mahmutkucukakyuz-iuc/robotik_vize/rapor/sonuclar/fk_error_20261030_123836.md

| Konf. | q (deg) | p_FK (m) | p_ROS /ee_pose (m) | e_ROS (mm) | p_Gazebo (m) | e_Gazebo (mm) | e_Gazebo, FK(q_olc) (mm) |
|---|---|---|---|---|---|---|---|
| T1 | 0, 0, 0, 0, 0, 0 | 0.0000, -0.0008, 0.7921 | 0.0000, -0.0008, 0.7921 | 0.0000 | 0.0000, -0.0008, 0.7921 | 0.0003 | 0.0003 |
| T2 | 45, 20, 0, 0, 0, 0 | 0.1604, 0.1593, 0.7523 | 0.1604, 0.1593, 0.7523 | 0.0000 | 0.1604, 0.1593, 0.7523 | 0.0003 | 0.0003 |
| T3 | 0, 30, 0, 0, 0, 0 | 0.3304, -0.0008, 0.7036 | 0.3304, -0.0008, 0.7036 | 0.0000 | 0.3304, -0.0008, 0.7036 | 0.0001 | 0.0001 |
| T4 | 0, 0, 60, 0, 0, 0 | 0.3732, -0.0008, 0.5767 | 0.3732, -0.0008, 0.5767 | 0.0000 | 0.3732, -0.0008, 0.5767 | 0.0003 | 0.0003 |
| T5 | 0, 0, 0, 0, 60, 0 | 0.1740, -0.0008, 0.6917 | 0.1740, -0.0008, 0.6917 | 0.0000 | 0.1740, -0.0008, 0.6917 | 0.0002 | 0.0002 |
| T6 | -45, 20, 45, 0, -30, 0 | 0.2839, -0.2850, 0.6092 | 0.2839, -0.2850, 0.6092 | 0.0000 | 0.2839, -0.2850, 0.6092 | 0.0004 | 0.0004 |
| T7 | 60, -20, 70, 45, 30, 80 | 0.0757, 0.3102, 0.5169 | 0.0757, 0.3102, 0.5169 | 0.0000 | 0.0757, 0.3102, 0.5169 | 0.0001 | 0.0001 |
| T8 | -30, 45, 45, -60, 60, -45 | 0.3677, -0.3491, 0.2641 | 0.3677, -0.3491, 0.2641 | 0.0000 | 0.3677, -0.3491, 0.2641 | 0.0002 | 0.0002 |
| T9 | 85, 10, 80, 30, -45, 30 | 0.0987, 0.4049, 0.4478 | 0.0987, 0.4049, 0.4478 | 0.0000 | 0.0987, 0.4049, 0.4478 | 0.0001 | 0.0001 |
| T10 | -75, -30, 100, -85, 85, 60 | -0.1090, -0.1338, 0.4605 | -0.1090, -0.1338, 0.4605 | 0.0000 | -0.1090, -0.1338, 0.4605 | 0.0005 | 0.0005 |

**e_ROS:** ortalama = 0.0000 mm, std (n-1) = 0.0000 mm

**e_Gazebo [FK(q_komut)]:** ortalama = 0.0002 mm, std (n-1) = 0.0001 mm

**e_Gazebo [FK(q_olculen)]:** ortalama = 0.0002 mm, std (n-1) = 0.0001 mm
