mahmutkucukakyuz-iuc/robotik_vize/rapor/sonuclar/sekil6_kamera_ham.png

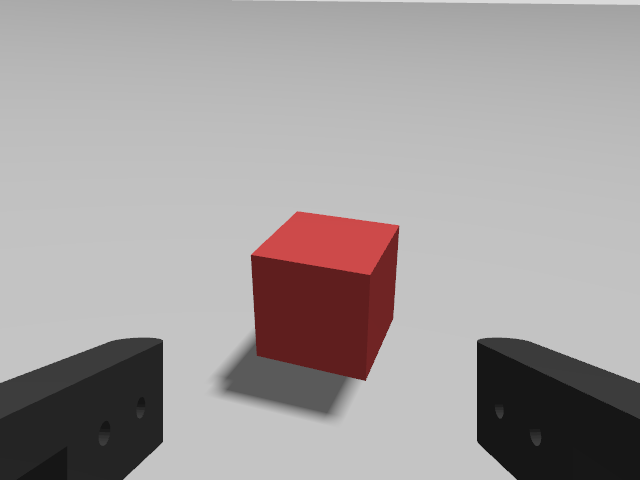
rapor/sonuclar/sekil6_kamera_ham.png
