mahmutkucukakyuz-iuc/robotik_vize/ros2_ws/src/rk6_description/meshes/link2.stl

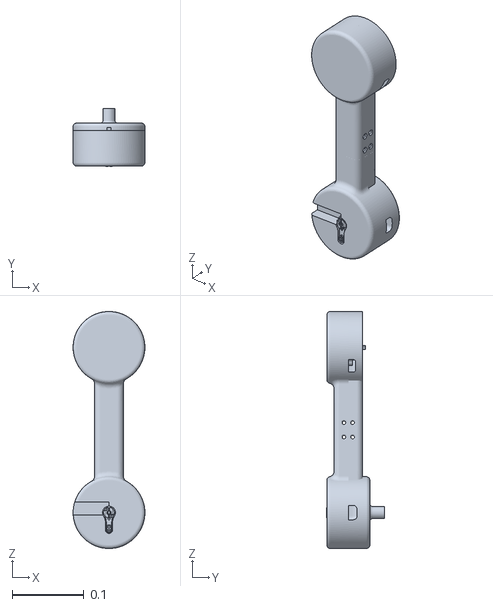
[picture p26: CAD file, 2026-11-08]
ros2_ws/src/rk6_description/meshes/link2.stl
0.1 x 0.0801 x 0.33
