mahmutkucukakyuz-iuc/robotik_vize/ros2_ws/src/rk6_description/meshes/gripper_left_finger.stl

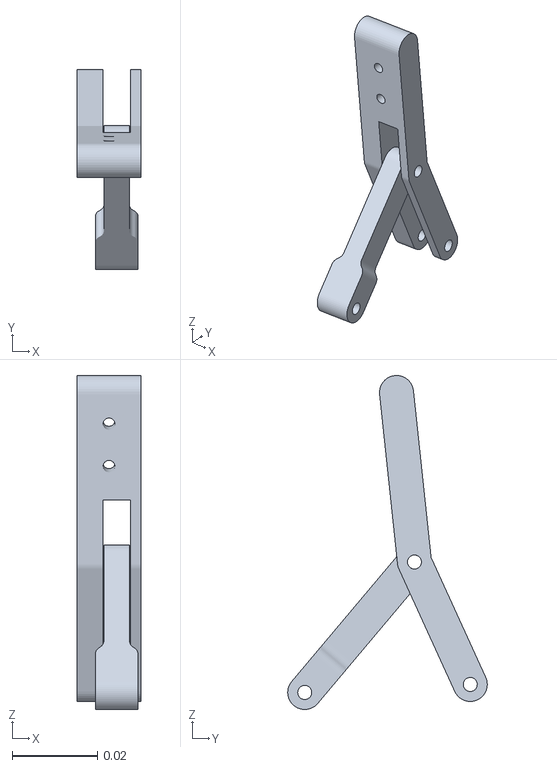
[picture p27: CAD file, 2026-11-08]
ros2_ws/src/rk6_description/meshes/gripper_left_finger.stl
0.015 x 0.0468 x 0.0784
