mahmutkucukakyuz-iuc/robotik_vize/ros2_ws/src/rk6_description/meshes/link3.stl

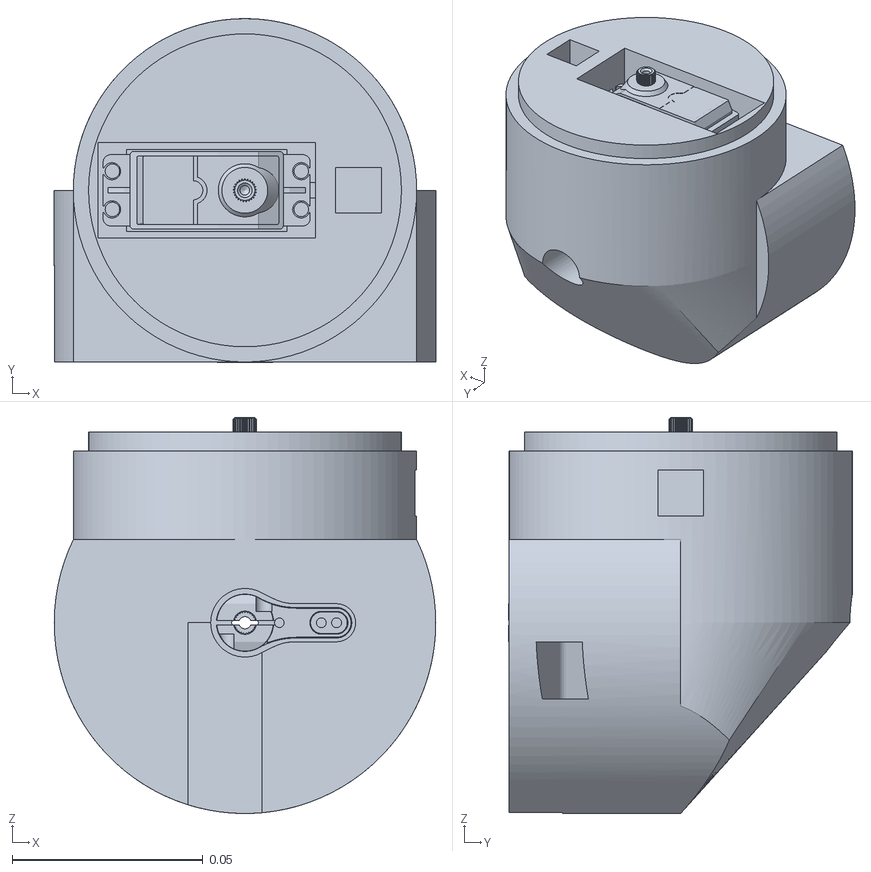
[picture p28: CAD file, 2026-11-08]
ros2_ws/src/rk6_description/meshes/link3.stl
0.1 x 0.0901 x 0.104
