mahmutkucukakyuz-iuc/robotik_vize/ros2_ws/src/rk6_description/meshes/link4.stl

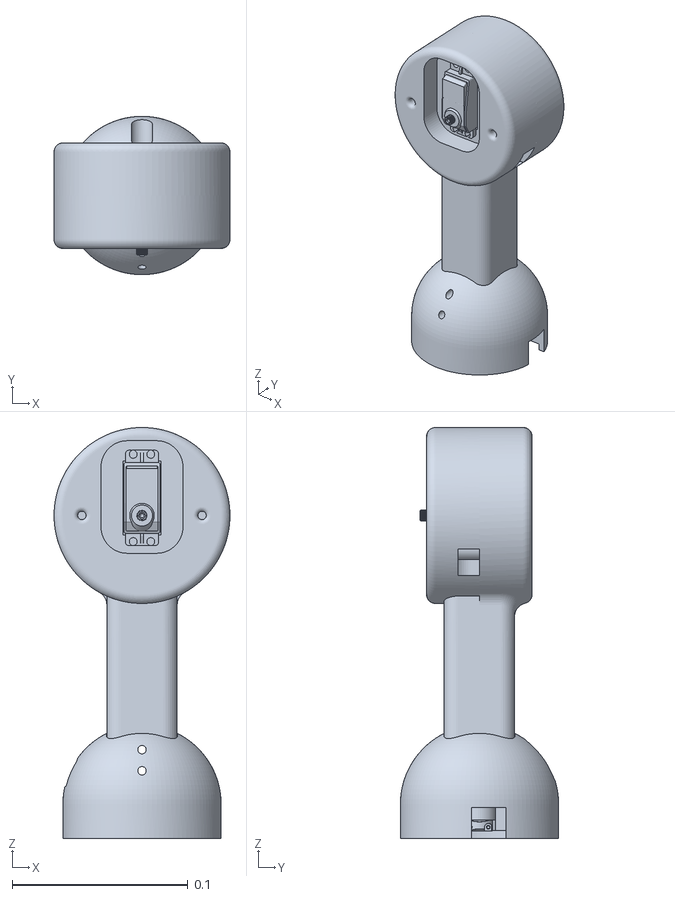
[picture p29: CAD file, 2026-11-08]
ros2_ws/src/rk6_description/meshes/link4.stl
0.1 x 0.09 x 0.234
