mahmutkucukakyuz-iuc/robotik_vize/ros2_ws/src/rk6_description/meshes/base_link.stl

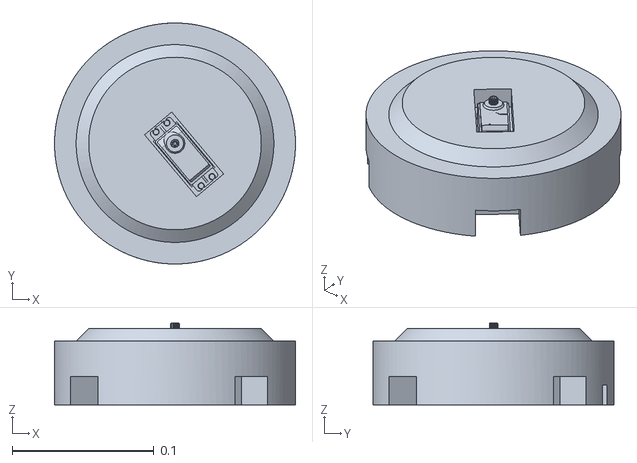
[picture p30: CAD file, 2026-11-08]
ros2_ws/src/rk6_description/meshes/base_link.stl
0.17 x 0.17 x 0.0577
