mahmutkucukakyuz-iuc/robotik_vize/ros2_ws/src/rk6_description/meshes/link6.stl

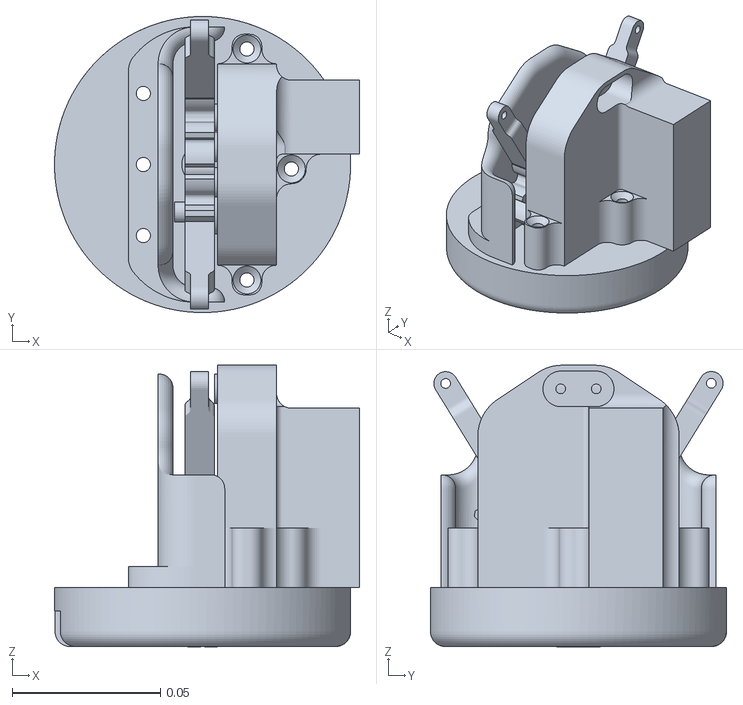
[picture p31: CAD file, 2026-11-08]
ros2_ws/src/rk6_description/meshes/link6.stl
0.103 x 0.1 x 0.0951
