mahmutkucukakyuz-iuc/robotik_vize/ros2_ws/src/rk6_description/meshes/link5.stl

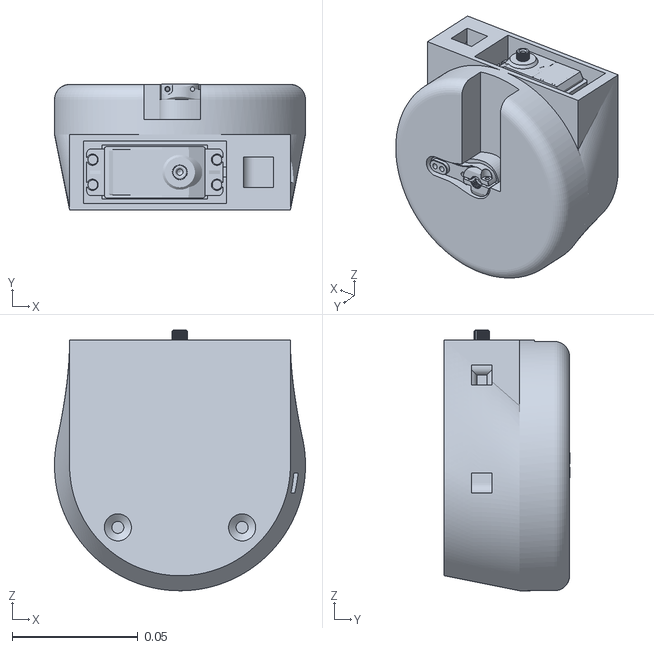
[picture p32: CAD file, 2026-11-08]
ros2_ws/src/rk6_description/meshes/link5.stl
0.1 x 0.0501 x 0.104
