mahmutkucukakyuz-iuc/robotik_vize/ros2_ws/src/rk6_description/meshes/link1.stl

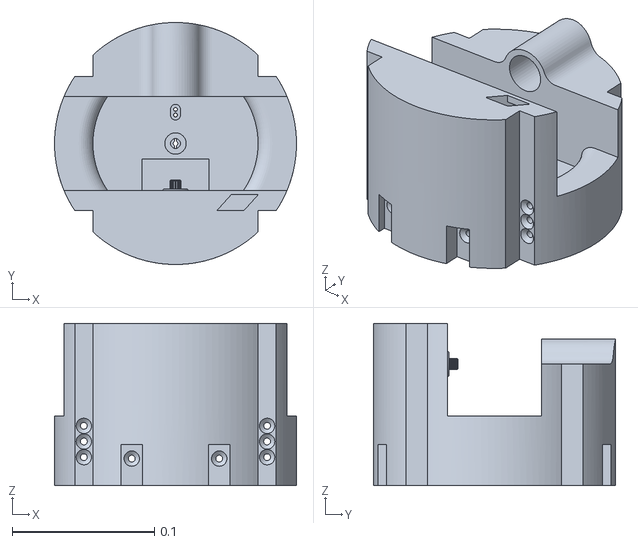
[picture p33: CAD file, 2026-11-08]
ros2_ws/src/rk6_description/meshes/link1.stl
0.17 x 0.17 x 0.114
