mahmutkucukakyuz-iuc/robotik_vize/(list of files, cad)

Other CAD files:
ros2_ws/src/rk6_description/meshes/gripper_right_finger.stl
