mahmutkucukakyuz-iuc/robotik_vize/ros2_ws/src/rk6_description/urdf/rk6.urdf

<?xml version="1.0"?>
<!--
  rk6.urdf : rk6.urdf.xacro dosyasinin xacro ile genisletilmis duz URDF kopyasi (Fusion kolu).
  SADECE REFERANS: Launch dosyalari HER ZAMAN rk6.urdf.xacro kullanir. Buradaki gz_ros2_control
  <parameters> yolu yer tutucudur (rk6_controllers.yaml); Gazebo icin xacro surumunu kullanin.
  Mesh yollari package://rk6_description/meshes/... (paket kurulu olmali).
  Yeniden uretmek icin (WSL, ~/rt_ws derlendikten sonra):
    xacro $(ros2 pkg prefix rk6_description)/share/rk6_description/urdf/rk6.urdf.xacro controllers_file:=rk6_controllers.yaml
-->
<!-- =================================================================================== -->
<!-- |    This document was autogenerated by xacro from ~/rt_ws/install/rk6_description/share/rk6_description/urdf/rk6.urdf.xacro | -->
<!-- |    EDITING THIS FILE BY HAND IS NOT RECOMMENDED                                 | -->
<!-- =================================================================================== -->
<!--
  rk6: ogrencinin gercek kolu (Fusion 360 export). Ana Xacro dosyasi.
  Kaynak: Fusion entegrasyon araclari (eklemler: kinematics_spec.json; mesh'ler: mesh_groups.json + mesh_birlestir.py; depoya dahil degil).

  ===================== URDF KURALI =====================
  Sifir pozda (q = 0) kol dimdik yukari bakar ve TUM link cerceveleri base_link ile paraleldir (rpy = 0).
  Eklem eksenleri: J1, J4, J6 = z ; J2, J3, J5 = y. Pozitif q2/q3/q5 kolu +x (one) eger.
  base_link: J1 ekseni uzerinde, taban plakasinin ALT yuzeyi (= zemin, world z = 0). x = kolun one uzandigi yon
             (CAD'de iki on ayagin arasi; ayaklar simulasyonda yok), z yukari.
  tool0: parmak ic yuzeylerinin (pad) ortasi, J6 ekseni uzerinde. z = yaklasma, y = parmak acilma yonu.

     joint  | parent    | child  | origin xyz [m]            | axis
     joint1 | base_link | link1  | 0   0        0.0547       | 0 0 1
     joint2 | link1     | link2  | 0  -0.0308   0.0766       | 0 1 0
     joint3 | link2     | link3  | 0   0.0509   0.22995      | 0 1 0
     joint4 | link3     | link4  | 0   0.0451   0.0508       | 0 0 1
     joint5 | link4     | link5  | 0  -0.0309   0.17915      | 0 1 0
     joint6 | link5     | link6  | 0  -0.0351   0.0508       | 0 0 1
     tool0_joint (fixed) link6 -> tool0 : xyz 0 0 0.15013

  ===================== ESDEGER DH (standart) =====================
  A_i = Rz(theta_i + off_i) Tz(d_i) Tx(a_i) Rx(alpha_i),  base_link_T_tool0 = A1 A2 ... A6  (sabit base/tool donusumu yok)

     i | off_i  | d_i [m]  | a_i [m]  | alpha_i
     1 |   0    |  0.1313  |  0       |  -pi/2
     2 | -pi/2  |  0       |  0.22995 |   0
     3 | +pi/2  |  0.0652  |  0       |  +pi/2
     4 |   0    |  0.22995 |  0       |  -pi/2
     5 |   0    | -0.0660  |  0       |  +pi/2
     6 |   0    |  0.20093 |  0       |   0
  URDF q_i = DH theta_i (offset'ler DH tablosunda). Dogrulama: 200 rastgele q icin URDF FK == DH FK (< 1e-9).

  Geometrik sinif: R ⊢ R ∥ R (articulated); d5 kacikligi nedeniyle bilek kuresel degil.
  ===============================================================
-->
<robot name="rk6">
  <!-- Renkler (her link farkli renk) -->
  <material name="rk6_grey">
    <color rgba="0.35 0.35 0.38 1.0"/>
  </material>
  <material name="rk6_orange">
    <color rgba="1.00 0.50 0.05 1.0"/>
  </material>
  <material name="rk6_blue">
    <color rgba="0.10 0.35 0.85 1.0"/>
  </material>
  <material name="rk6_green">
    <color rgba="0.15 0.70 0.30 1.0"/>
  </material>
  <material name="rk6_yellow">
    <color rgba="0.95 0.85 0.10 1.0"/>
  </material>
  <material name="rk6_purple">
    <color rgba="0.55 0.25 0.75 1.0"/>
  </material>
  <material name="rk6_red">
    <color rgba="0.85 0.15 0.15 1.0"/>
  </material>
  <material name="rk6_black">
    <color rgba="0.05 0.05 0.05 1.0"/>
  </material>
  <!-- +-90 -->
  <!-- ========== world & base ========== -->
  <link name="world"/>
  <joint name="world_joint" type="fixed">
    <parent link="world"/>
    <child link="base_link"/>
    <origin rpy="0 0 0" xyz="0 0 0.0"/>
  </joint>
  <link name="base_link">
    <visual>
      <origin rpy="0 0 0" xyz="0 0 0"/>
      <geometry>
        <mesh filename="package://rk6_description/meshes/base_link.stl"/>
      </geometry>
      <material name="rk6_grey"/>
    </visual>
    <collision>
      <origin rpy="0 0 0" xyz="0.00003 -0.00004 0.02885"/>
      <geometry>
        <box size="0.17000 0.17000 0.05770"/>
      </geometry>
    </collision>
    <inertial>
      <origin rpy="0 0 0" xyz="0.00052 -0.00105 0.02697"/>
      <mass value="0.494"/>
      <inertia ixx="0.0006501" ixy="0" ixz="0" iyy="0.0006501" iyz="0" izz="0.001166"/>
    </inertial>
  </link>
  <!-- ========== joint1 / link1 (taban donusu, dusey eksen) ========== -->
  <joint name="joint1" type="revolute">
    <parent link="base_link"/>
    <child link="link1"/>
    <origin rpy="0 0 0" xyz="0 0 0.0547"/>
    <axis xyz="0 0 1"/>
    <limit effort="100.0" lower="-2.356194" upper="2.356194" velocity="2.0"/>
    <dynamics damping="0.5" friction="0.0"/>
  </joint>
  <link name="link1">
    <visual>
      <origin rpy="0 0 0" xyz="0 0 0"/>
      <geometry>
        <mesh filename="package://rk6_description/meshes/link1.stl"/>
      </geometry>
      <material name="rk6_orange"/>
    </visual>
    <collision>
      <origin rpy="0 0 0" xyz="0.00000 0.00000 0.04810"/>
      <geometry>
        <box size="0.17000 0.17000 0.11400"/>
      </geometry>
    </collision>
    <inertial>
      <origin rpy="0 0 0" xyz="-0.00048 -0.01086 0.04003"/>
      <mass value="0.674"/>
      <inertia ixx="0.001153" ixy="0" ixz="0" iyy="0.001153" iyz="0" izz="0.001591"/>
    </inertial>
  </link>
  <!-- ========== joint2 / link2 (omuz) ========== -->
  <joint name="joint2" type="revolute">
    <parent link="link1"/>
    <child link="link2"/>
    <origin rpy="0 0 0" xyz="0 -0.0308 0.0766"/>
    <axis xyz="0 1 0"/>
    <limit effort="100.0" lower="-1.570796" upper="1.570796" velocity="2.0"/>
    <dynamics damping="0.5" friction="0.0"/>
  </joint>
  <link name="link2">
    <visual>
      <origin rpy="0 0 0" xyz="0 0 0"/>
      <geometry>
        <mesh filename="package://rk6_description/meshes/link2.stl"/>
      </geometry>
      <material name="rk6_blue"/>
    </visual>
    <collision>
      <origin rpy="0 0 0" xyz="0.00000 0.04005 0.11500"/>
      <geometry>
        <box size="0.10000 0.08010 0.33000"/>
      </geometry>
    </collision>
    <inertial>
      <origin rpy="0 0 0" xyz="-0.00007 0.02779 0.11678"/>
      <mass value="0.4205"/>
      <inertia ixx="0.00198" ixy="0" ixz="0" iyy="0.002042" iyz="0" izz="0.0002819"/>
    </inertial>
  </link>
  <!-- ========== joint3 / link3 (dirsek) ========== -->
  <joint name="joint3" type="revolute">
    <parent link="link2"/>
    <child link="link3"/>
    <origin rpy="0 0 0" xyz="0 0.0509 0.22995"/>
    <axis xyz="0 1 0"/>
    <limit effort="60.0" lower="-2.356194" upper="2.356194" velocity="2.0"/>
    <dynamics damping="0.5" friction="0.0"/>
  </joint>
  <link name="link3">
    <visual>
      <origin rpy="0 0 0" xyz="0 0 0"/>
      <geometry>
        <mesh filename="package://rk6_description/meshes/link3.stl"/>
      </geometry>
      <material name="rk6_green"/>
    </visual>
    <collision>
      <origin rpy="0 0 0" xyz="0.00000 0.04505 0.00190"/>
      <geometry>
        <box size="0.10000 0.09010 0.10380"/>
      </geometry>
    </collision>
    <inertial>
      <origin rpy="0 0 0" xyz="-0.00194 0.03969 0.00880"/>
      <mass value="0.2745"/>
      <inertia ixx="0.0002118" ixy="0" ixz="0" iyy="0.0002329" iyz="0" izz="0.0002031"/>
    </inertial>
  </link>
  <!-- ========== joint4 / link4 (on kol donusu) ========== -->
  <joint name="joint4" type="revolute">
    <parent link="link3"/>
    <child link="link4"/>
    <origin rpy="0 0 0" xyz="0 0.0451 0.0508"/>
    <axis xyz="0 0 1"/>
    <limit effort="30.0" lower="-1.570796" upper="1.570796" velocity="2.0"/>
    <dynamics damping="0.3" friction="0.0"/>
  </joint>
  <link name="link4">
    <visual>
      <origin rpy="0 0 0" xyz="0 0 0"/>
      <geometry>
        <mesh filename="package://rk6_description/meshes/link4.stl"/>
      </geometry>
      <material name="rk6_yellow"/>
    </visual>
    <collision>
      <origin rpy="0 0 0" xyz="-0.00005 0.00000 0.11240"/>
      <geometry>
        <box size="0.10000 0.09000 0.23360"/>
      </geometry>
    </collision>
    <inertial>
      <origin rpy="0 0 0" xyz="-0.00039 -0.00076 0.12653"/>
      <mass value="0.35"/>
      <inertia ixx="0.0008955" ixy="0" ixz="0" iyy="0.0009227" iyz="0" izz="0.0002586"/>
    </inertial>
  </link>
  <!-- ========== joint5 / link5 (bilek egilme) ========== -->
  <joint name="joint5" type="revolute">
    <parent link="link4"/>
    <child link="link5"/>
    <origin rpy="0 0 0" xyz="0 -0.0309 0.17915"/>
    <axis xyz="0 1 0"/>
    <limit effort="30.0" lower="-1.570796" upper="1.570796" velocity="2.0"/>
    <dynamics damping="0.3" friction="0.0"/>
  </joint>
  <link name="link5">
    <visual>
      <origin rpy="0 0 0" xyz="0 0 0"/>
      <geometry>
        <mesh filename="package://rk6_description/meshes/link5.stl"/>
      </geometry>
      <material name="rk6_purple"/>
    </visual>
    <collision>
      <origin rpy="0 0 0" xyz="-0.00004 -0.02505 0.00188"/>
      <geometry>
        <box size="0.09999 0.05010 0.10380"/>
      </geometry>
    </collision>
    <inertial>
      <origin rpy="0 0 0" xyz="-0.00253 -0.02710 0.00691"/>
      <mass value="0.199"/>
      <inertia ixx="0.0001079" ixy="0" ixz="0" iyy="0.0001688" iyz="0" izz="0.0001016"/>
    </inertial>
  </link>
  <!-- ========== joint6 / link6 (gripper donusu) ========== -->
  <joint name="joint6" type="revolute">
    <parent link="link5"/>
    <child link="link6"/>
    <origin rpy="0 0 0" xyz="0 -0.0351 0.0508"/>
    <axis xyz="0 0 1"/>
    <limit effort="20.0" lower="-1.570796" upper="1.570796" velocity="2.0"/>
    <dynamics damping="0.2" friction="0.0"/>
  </joint>
  <link name="link6">
    <visual>
      <origin rpy="0 0 0" xyz="0 0 0"/>
      <geometry>
        <mesh filename="package://rk6_description/meshes/link6.stl"/>
      </geometry>
      <material name="rk6_red"/>
    </visual>
    <collision>
      <origin rpy="0 0 0" xyz="0.00140 0.00001 0.04753"/>
      <geometry>
        <box size="0.10299 0.09998 0.09510"/>
      </geometry>
    </collision>
    <inertial>
      <origin rpy="0 0 0" xyz="0.01095 0.00465 0.04043"/>
      <mass value="0.2454"/>
      <inertia ixx="0.0001908" ixy="0" ixz="0" iyy="0.0001969" iyz="0" izz="0.0002064"/>
    </inertial>
  </link>
  <!-- ========== uc-efektor cercevesi tool0 = DH cercevesi 6 (parmak pad ortasi) ========== -->
  <joint name="tool0_joint" type="fixed">
    <parent link="link6"/>
    <child link="tool0"/>
    <origin rpy="0 0 0" xyz="0 0 0.15013"/>
  </joint>
  <link name="tool0">
    <inertial>
      <origin rpy="0 0 0" xyz="0 0 0"/>
      <mass value="0.01"/>
      <inertia ixx="1e-6" ixy="0" ixz="0" iyy="1e-6" iyz="0" izz="1e-6"/>
    </inertial>
  </link>
  <!-- ========== Sensor cerceveleri ========== -->
  <!-- Bilek kamerasi: gripper'in duz -x plaka yuzune (servonun karsi tarafi) disaridan monte
       (kutu plakaya temas eder, ~2 mm gomulu). Kutu merkezi link6'da (-0.0256, 0, 0.075);
       mercek (kutunun +x_camera yuzu) link6'da z = 0.085. Bakis yonu (+x camera) = link6/tool0 +z
       (yaklasma yonu). Goruntu yatay ekseni = parmak acilma yonu (y). -->
  <joint name="camera_joint" type="fixed">
    <parent link="link6"/>
    <child link="camera_link"/>
    <origin rpy="0 -1.5707963267948966 0" xyz="-0.0256 0 0.075"/>
  </joint>
  <link name="camera_link">
    <visual>
      <origin rpy="0 0 0" xyz="0 0 0"/>
      <geometry>
        <box size="0.02 0.035 0.025"/>
      </geometry>
      <material name="rk6_black"/>
    </visual>
    <collision>
      <origin rpy="0 0 0" xyz="0 0 0"/>
      <geometry>
        <box size="0.02 0.035 0.025"/>
      </geometry>
    </collision>
    <inertial>
      <origin rpy="0 0 0" xyz="0 0 0"/>
      <mass value="0.02"/>
      <inertia ixx="1e-6" ixy="0" ixz="0" iyy="1e-6" iyz="0" izz="1e-6"/>
    </inertial>
  </link>
  <!-- IMU: link6 icinde (gripper tabani ustu), eksenleri link6 ile ayni -->
  <joint name="imu_joint" type="fixed">
    <parent link="link6"/>
    <child link="imu_link"/>
    <origin rpy="0 0 0" xyz="0 0 0.03"/>
  </joint>
  <link name="imu_link">
    <inertial>
      <origin rpy="0 0 0" xyz="0 0 0"/>
      <mass value="0.01"/>
      <inertia ixx="1e-6" ixy="0" ixz="0" iyy="1e-6" iyz="0" izz="1e-6"/>
    </inertial>
  </link>
  <joint name="gripper_left_finger_joint" type="prismatic">
    <parent link="link6"/>
    <child link="gripper_left_finger"/>
    <origin rpy="0 0 0" xyz="0 0 0"/>
    <axis xyz="0 1 0"/>
    <!-- Sinirlarda kucuk pay: parmak 0'da dururken fizik motoru -1e-19 gibi degerler
           raporlar; sinir tam 0 olursa ros2_control limit korumasi komutu engelliyor -->
    <limit effort="20.0" lower="-0.002" upper="0.025" velocity="0.1"/>
    <dynamics damping="1.0" friction="0.0"/>
  </joint>
  <link name="gripper_left_finger">
    <visual>
      <origin rpy="0 0 0" xyz="0 0 0"/>
      <geometry>
        <mesh filename="package://rk6_description/meshes/gripper_left_finger.stl"/>
      </geometry>
      <material name="rk6_black"/>
    </visual>
    <!-- carpisma: sadece parmak ucu pad'i (kavrama yuzeyi) -->
    <collision>
      <origin rpy="0 0 0" xyz="-0.0029 0.004 0.143"/>
      <geometry>
        <box size="0.015 0.008 0.036"/>
      </geometry>
    </collision>
    <inertial>
      <origin rpy="0 0 0" xyz="-0.00288 0.00475 0.12027"/>
      <mass value="0.02"/>
      <inertia ixx="1e-05" ixy="0" ixz="0" iyy="1e-05" iyz="0" izz="1e-05"/>
    </inertial>
  </link>
  <!-- Kavrama icin yuksek surtunme ve sert temas (nesne parmaklar arasindan kaymasin) -->
  <gazebo reference="gripper_left_finger">
    <mu1>1.5</mu1>
    <mu2>1.5</mu2>
    <kp>1000000.0</kp>
    <kd>100.0</kd>
    <minDepth>0.001</minDepth>
    <maxVel>0.1</maxVel>
  </gazebo>
  <joint name="gripper_right_finger_joint" type="prismatic">
    <parent link="link6"/>
    <child link="gripper_right_finger"/>
    <origin rpy="0 0 0" xyz="0 0 0"/>
    <axis xyz="0 -1 0"/>
    <!-- Sinirlarda kucuk pay: parmak 0'da dururken fizik motoru -1e-19 gibi degerler
           raporlar; sinir tam 0 olursa ros2_control limit korumasi komutu engelliyor -->
    <limit effort="20.0" lower="-0.002" upper="0.025" velocity="0.1"/>
    <dynamics damping="1.0" friction="0.0"/>
  </joint>
  <link name="gripper_right_finger">
    <visual>
      <origin rpy="0 0 0" xyz="0 0 0"/>
      <geometry>
        <mesh filename="package://rk6_description/meshes/gripper_right_finger.stl"/>
      </geometry>
      <material name="rk6_black"/>
    </visual>
    <!-- carpisma: sadece parmak ucu pad'i (kavrama yuzeyi) -->
    <collision>
      <origin rpy="0 0 0" xyz="-0.0029 -0.004 0.143"/>
      <geometry>
        <box size="0.015 0.008 0.036"/>
      </geometry>
    </collision>
    <inertial>
      <origin rpy="0 0 0" xyz="-0.00288 -0.00470 0.12024"/>
      <mass value="0.02"/>
      <inertia ixx="1e-05" ixy="0" ixz="0" iyy="1e-05" iyz="0" izz="1e-05"/>
    </inertial>
  </link>
  <!-- Kavrama icin yuksek surtunme ve sert temas (nesne parmaklar arasindan kaymasin) -->
  <gazebo reference="gripper_right_finger">
    <mu1>1.5</mu1>
    <mu2>1.5</mu2>
    <kp>1000000.0</kp>
    <kd>100.0</kd>
    <minDepth>0.001</minDepth>
    <maxVel>0.1</maxVel>
  </gazebo>
  <!-- ========== kavrama noktasi (TCP) = tool0 ========== -->
  <joint name="gripper_tcp_joint" type="fixed">
    <parent link="tool0"/>
    <child link="gripper_tcp"/>
    <origin rpy="0 0 0" xyz="0 0 0"/>
  </joint>
  <link name="gripper_tcp">
    <inertial>
      <origin rpy="0 0 0" xyz="0 0 0"/>
      <mass value="0.001"/>
      <inertia ixx="1e-6" ixy="0" ixz="0" iyy="1e-6" iyz="0" izz="1e-6"/>
    </inertial>
  </link>
  <ros2_control name="GazeboSimSystem" type="system">
    <hardware>
      <plugin>gz_ros2_control/GazeboSimSystem</plugin>
    </hardware>
    <joint name="joint1">
      <command_interface name="position">
        <param name="min">-2.356194</param>
        <param name="max">2.356194</param>
      </command_interface>
      <state_interface name="position">
        <param name="initial_value">0.0</param>
      </state_interface>
      <state_interface name="velocity"/>
      <state_interface name="effort"/>
    </joint>
    <joint name="joint2">
      <command_interface name="position">
        <param name="min">-1.570796</param>
        <param name="max">1.570796</param>
      </command_interface>
      <state_interface name="position">
        <param name="initial_value">0.0</param>
      </state_interface>
      <state_interface name="velocity"/>
      <state_interface name="effort"/>
    </joint>
    <joint name="joint3">
      <command_interface name="position">
        <param name="min">-2.356194</param>
        <param name="max">2.356194</param>
      </command_interface>
      <state_interface name="position">
        <param name="initial_value">0.0</param>
      </state_interface>
      <state_interface name="velocity"/>
      <state_interface name="effort"/>
    </joint>
    <joint name="joint4">
      <command_interface name="position">
        <param name="min">-1.570796</param>
        <param name="max">1.570796</param>
      </command_interface>
      <state_interface name="position">
        <param name="initial_value">0.0</param>
      </state_interface>
      <state_interface name="velocity"/>
      <state_interface name="effort"/>
    </joint>
    <joint name="joint5">
      <command_interface name="position">
        <param name="min">-1.570796</param>
        <param name="max">1.570796</param>
      </command_interface>
      <state_interface name="position">
        <param name="initial_value">0.0</param>
      </state_interface>
      <state_interface name="velocity"/>
      <state_interface name="effort"/>
    </joint>
    <joint name="joint6">
      <command_interface name="position">
        <param name="min">-1.570796</param>
        <param name="max">1.570796</param>
      </command_interface>
      <state_interface name="position">
        <param name="initial_value">0.0</param>
      </state_interface>
      <state_interface name="velocity"/>
      <state_interface name="effort"/>
    </joint>
    <joint name="gripper_left_finger_joint">
      <command_interface name="position">
        <param name="min">-0.002</param>
        <param name="max">0.025</param>
      </command_interface>
      <state_interface name="position">
        <param name="initial_value">0.0</param>
      </state_interface>
      <state_interface name="velocity"/>
      <state_interface name="effort"/>
    </joint>
    <joint name="gripper_right_finger_joint">
      <command_interface name="position">
        <param name="min">-0.002</param>
        <param name="max">0.025</param>
      </command_interface>
      <state_interface name="position">
        <param name="initial_value">0.0</param>
      </state_interface>
      <state_interface name="velocity"/>
      <state_interface name="effort"/>
    </joint>
  </ros2_control>
  <!-- ros2_control <-> Gazebo baglantisi (controller_manager bu eklenti icinde calisir) -->
  <gazebo>
    <plugin filename="gz_ros2_control-system" name="gz_ros2_control::GazeboSimROS2ControlPlugin">
      <parameters>rk6_controllers.yaml</parameters>
    </plugin>
  </gazebo>
  <!-- Simulatorden olculen (ground-truth) link pozlari: /rk6/pose (gz.msgs.Pose_V)
       ros_gz_bridge ile ROS'ta /gz_link_poses (tf2_msgs/TFMessage) olarak okunur.
       Her poz model cercevesine (rk6) goredir; FK hata analizinde
       base_T_tool0 = (model_T_base_link)^-1 * model_T_tool0 hesaplanir. -->
  <gazebo>
    <plugin filename="gz-sim-pose-publisher-system" name="gz::sim::systems::PosePublisher">
      <publish_link_pose>true</publish_link_pose>
      <publish_sensor_pose>false</publish_sensor_pose>
      <publish_collision_pose>false</publish_collision_pose>
      <publish_visual_pose>false</publish_visual_pose>
      <publish_nested_model_pose>false</publish_nested_model_pose>
      <use_pose_vector_msg>true</use_pose_vector_msg>
      <static_publisher>false</static_publisher>
      <update_frequency>50</update_frequency>
    </plugin>
  </gazebo>
  <!-- tool0 (ve base_link) Gazebo'da ayri link olarak kalsin: sabit eklem birlestirmesini (lumping) engelle.
       Boylece PosePublisher dogrudan tool0 pozunu yayinlar. -->
  <gazebo reference="tool0_joint">
    <preserveFixedJoint>true</preserveFixedJoint>
  </gazebo>
  <!-- Bilek kamerasi -> gz konu: /wrist_camera/image (+ /wrist_camera/camera_info) -->
  <gazebo reference="camera_link">
    <sensor name="wrist_camera" type="camera">
      <always_on>1</always_on>
      <update_rate>30</update_rate>
      <visualize>true</visualize>
      <topic>wrist_camera/image</topic>
      <gz_frame_id>camera_link</gz_frame_id>
      <camera>
        <horizontal_fov>1.047</horizontal_fov>
        <image>
          <width>640</width>
          <height>480</height>
          <format>R8G8B8</format>
        </image>
        <clip>
          <near>0.02</near>
          <far>50.0</far>
        </clip>
      </camera>
    </sensor>
  </gazebo>
  <!-- IMU -> gz konu: /imu -->
  <gazebo reference="imu_link">
    <sensor name="imu_sensor" type="imu">
      <always_on>1</always_on>
      <update_rate>100</update_rate>
      <visualize>true</visualize>
      <topic>imu</topic>
      <gz_frame_id>imu_link</gz_frame_id>
    </sensor>
  </gazebo>
</robot>
